chenminsay2025/papercutting/docs/wiring-diagram.html

# CutPPaper 接线图

STM32F103C8T6 · 点击节点查看说明

总览思维导图 总接线图 工艺流程 引脚图 ST-LINK USB-TTL 伸缩杆 四路继电器 电源共地

电脑软件 通信/烧录 伸缩杆 继电器 电源 STM32

### 图层显示 · 点击切换

精简视图 全部显示 仅串口 仅电机 仅继电器 仅电源 隐藏软件/注释

连线

元件 / 非硬件

连接点 +24V +3V3 GND 电机 LED 继电器 串口 ST-LINK 按钮触点 软件虚线

序号 | 起点 | 终点 | 线色建议 | 要求
1 | USB-TTL TX | STM32 PA10 (RX) | 红 | 交叉接线，必须 3.3V TTL
2 | USB-TTL RX | STM32 PA9 (TX) | 红 | 交叉接线，115200 8N1
3 | USB-TTL GND | STM32 GND | 黑 | 必须共地；VCC 勿接 MCU
4 | ST-LINK SWDIO | STM32 PA13 | 绿 | 烧录用，可与 TTL 同时连接
5 | ST-LINK SWCLK | STM32 PA14 | 蓝 | 烧录用
6 | ST-LINK GND | STM32 GND | 黑 | 必须共地
7 | ST-LINK 3.3V | STM32 3.3V | 红 | 可选，板子已有供电可不接
8 | DC-DC 输出 3.3V | STM32 3.3V | 红 | 禁止 24V 直连 MCU 引脚
9 | STM32 PA0 | 继电器 IN1 (K1) | 橙 | 缩回时与 PA1 同时吸合
10 | STM32 PA1 | 继电器 IN2 (K2) | 橙 | 伸出时单独吸合；换向前 STOP 80ms
11 | 24V+ | COM1 (K1) | 红 | 电机电源正极
12 | GND | COM2 (K2) | 黑 | 电机电源负极
13 | NO1 + NC1 | 电机正极 (+) | 橙 | 并到同一接线点
14 | NO2 | 电机负极 (−) | 橙 | NC2 悬空不接
15 | STM32 PA4 | D1 缩回 LED（经 330Ω） | 琥珀 | 缩回时亮
16 | STM32 PA5 | D2 伸出 LED（经 330Ω） | 绿 | 伸出时亮
17 | STM32 PA6 | D3 串口 LED（经 330Ω） | 蓝 | 未连接快闪；已连接呼吸慢闪
18 | STM32 PA7 | 伸缩切换按钮 → GND | 灰 | 按一次缩回 3s，再按伸出 3s，交替
19 | 四路继电器 DC+ | 12V 电源正极 | 红 | 12V 光耦模块；5V 模块接 5V；勿接 24V
20 | 四路继电器 DC- | 系统 GND | 黑 | 与 STM32、TTL、ST-LINK 共地
21 | 跳线 S1~S4 | 插上跳线帽 | — | 高电平触发 IN1~IN4
22 | STM32 PA2 | 继电器 IN3 (K3) | 绿 | 脉冲 →「继续」
23 | COM3 + NO3 | 「继续」按钮 | 灰 | 并联；NC3 不接
24 | STM32 PA3 | 继电器 IN4 (K4) | 绿 | 脉冲 →「原点」
25 | COM4 + NO4 | 「原点」按钮 | 灰 | 并联；NC4 不接
26 | 24V 电源 GND | 共地总线 | 黑 | 所有模块 GND 汇到一点

### 接线检查清单（上电前必查）

- 共地：24V 负极、STM32、USB-TTL、ST-LINK、四路继电器 GND 全部相连
- 电压：STM32 仅 3.3V；USB-TTL 拨 3.3V；24V 只接 COM1/COM2 电机触点
- 串口：TX/RX 交叉（TTL TX→PA10，TTL RX←PA9），115200
- 电机 K1/K2：COM1←24V+、COM2←GND；NO1+NC1→电机+、NO2→电机−；NC2 不接；停止时断电
- 伸缩键 PA7：单键接 GND；按一次缩回 3s，再按伸出 3s，交替
- LED：PA4 缩回、PA5 伸出、PA6 串口；各串 330Ω 到 GND
- 按钮 K3/K4：PA2→IN3、PA3→IN4；COM3/NO3 继续、COM4/NO4 原点；NC3/NC4 不接
- 继电器 U4：DC+→12V、DC-→GND；S1~S4 跳线插 H（光耦模块可能无声）
- 走线：24V 电机线与信号线分开；电机线尽量粗、短，减少压降与干扰
- 软件：Cutting Master 4 由 PC 软件 Ctrl+P 触发，无需额外硬件连线

引脚 | 方向 | 连接 | 颜色
PA0 | 输出 | 四路继电器 IN1 / K1（缩回） | 橙
PA1 | 输出 | 四路继电器 IN2 / K2（伸出） | 橙
PA4 | 输出 | LED D1 缩回指示 | 琥珀
PA5 | 输出 | LED D2 伸出指示 | 绿
PA6 | 输出 | LED D3 串口状态 | 蓝
PA2 | 输出 | 四路继电器 IN3 / K3 → COM3/NO3 继续 | 绿
PA3 | 输出 | 四路继电器 IN4 / K4 → COM4/NO4 原点 | 绿
PA7 | 输入 | 伸缩切换按钮 → GND（按一次缩回 3s，再按伸出 3s） | 灰
PA9/10 | 串口 | USB-TTL 交叉连接 | 蓝
PA13/14 | SWD | ST-LINK 烧录 | 蓝

### ST-LINK 接线要点

- 线色建议：SWDIO 绿 · SWCLK 蓝 · GND 黑 · 3.3V 红（可选）
- 板子已有独立供电时，3.3V 可不接，只接 SWDIO、SWCLK、GND
- 与 USB-TTL 可同时连接，互不影响

### 交叉接线记忆法

- TTL 的 TX → MCU 的 RX (PA10)
- TTL 的 RX ← MCU 的 TX (PA9)
- 不要用 5V TTL 直连 STM32！VCC 不要接到 MCU

端子 | 接法 | 说明
IN1 (K1) | STM32 PA0 | 缩回时单独吸合
IN2 (K2) | STM32 PA1 | 伸出时单独吸合
PA7 | 切换按钮 → GND | 现场手动：每次 3 秒，缩回/伸出交替
COM1 | 24V+ | 电机电源正极
COM2 | GND | 电机电源负极
NO1 + NC1 | 电机正极 (+) | 并到同一接线点
NO2 | 电机负极 (−) | NC2 悬空

### 常见错误（请避免）

- 旧交叉接法（NO1+NC2、NC1+NO2）：停止时电机仍通电，须拆掉
- NC2 误接电机：停止时可能仍通电
- 24V 接到 DC+：会烧模块线圈电路
- 跳线插在 L：逻辑反相，继电器常吸合

端子 | 本方案接法 | 说明
DC+ | 12V 正极 | 12V 光耦模块；5V 模块接 5V；勿接 24V 或 STM32 3.3V
DC- | 系统 GND | 必须与 STM32 GND 共地
IN1 | STM32 PA0 | K1 缩回（与 K2 同时吸合）
IN2 | STM32 PA1 | K2 伸出（单独吸合）
IN3 | STM32 PA2 | K3 脉冲模拟「继续」
IN4 | STM32 PA3 | K4 脉冲模拟「原点」
S1 ~ S4 | 跳线插 H | 高电平触发；光耦模块可能无声
COM1 | 24V+ | 电机主电源正极
COM2 | GND (24V-) | 电机主电源负极
NO1 + NC1 | 电机正极 (+) | 见 wiring.md §5.3
NO2 | 电机负极 (−) | NC2 悬空
COM3 + NO3 | 「继续」按钮 | 干触点并联；NC3 悬空
COM4 + NO4 | 「原点」按钮 | 干触点并联；NC4 悬空

### 接线要点

- 四路全部使用：IN1/IN2 电机、IN3/IN4 按钮
- 缩回时 K1+K2 同时吸合；伸出时仅 K2；停止时全部释放
- 若继电器不吸合：检查 DC+ 是否有 12V、DC- 是否共地、跳线是否插 H
- 先用万用表确认机器按钮为 干触点（按下通、松开断），再并联 COM/NO
- 切勿把 220V 或未知强电按钮直接并联；强电须用隔离方案

### 电源规则

- 24V 只给电机和（如需）降压模块，不要接 STM32 引脚
- 24V 电源的 负极 = 系统 GND
- 电机线尽量粗、短；与信号线分开走
