chenminsay2025/papercutting/firmware/User/board.h

#ifndef __BOARD_H
#define __BOARD_H

#include "stm32f10x.h"

/* 四路继电器 H 桥：PA0=IN1 缩回，PA1=IN2 伸出；COM1/COM2 接电机 */
#define MOTOR_RETRACT_PIN   GPIO_Pin_0
#define MOTOR_EXTEND_PIN    GPIO_Pin_1
#define MOTOR_GPIO          GPIOA

/* 继电器: PA2=继续(A), PA3=原点(B) */
#define RELAY_A_PIN         GPIO_Pin_2
#define RELAY_B_PIN         GPIO_Pin_3
#define RELAY_GPIO          GPIOA

/* LED: PA4=缩回, PA5=伸出, PA6=串口连接 */
#define LED_RETRACT_PIN     GPIO_Pin_4
#define LED_EXTEND_PIN      GPIO_Pin_5
#define LED_COM_PIN         GPIO_Pin_6
#define LED_GPIO            GPIOA

/* 实体按键: PA7=伸缩切换（按下接 GND，内部上拉；每次 3 秒） */
#define BUTTON_TOGGLE_PIN   GPIO_Pin_7
#define BUTTON_GPIO         GPIOA
#define BUTTON_ACTION_MS    3000

/* USART1: PA9=TX, PA10=RX (USB-TTL) */
#define SERIAL_USART        USART1
#define SERIAL_BAUDRATE     115200

void Board_Init(void);
void Board_TickInc(void);
void Board_FeedWatchdog(void);
void Board_DelayMs(uint32_t ms);
uint32_t Board_GetTickMs(void);

#endif
