chenminsay2025/papercutting/(commit log)

2026-06-12 Initial commit: Electron UI, Python controller, and STM32 firmware for papercutting automation.
2026-06-13 Harden thread safety, firmware watchdogs, and config validation.
    Prevent client races during workflow, add IWDG and comm-timeout ESTOP on STM32, validate and atomically save config, and document wiring.
    [board.c, board.h, config.py, controller.py, cutting_master.py, main.c]
2026-06-13 Improve CM4 hotkey control, UI layout, wiring docs, and firmware reliability.
    Add configurable focus/hotkey timing, window focus restore, serial panel layout fixes, expanded wiring diagram, LED module, and USART error handling.
    [board.c, board.h, config.py, controller.py, cutting_master.py, led.c]
2026-06-13 Update wiring docs: telescopic rod motor uses 24V supply.
    Replace 12V references with 24V for BTS7960 motor power, buck converter notes, and diagram labels.
2026-06-14 Add editable vertical workflow steps with enable, insert, delete, and wait.
    Users can configure which steps run, insert custom wait steps mid-flow, and skip disabled steps at runtime; includes UI, backend workflow engine, wiring docs, and firmware updates.
    [board.h, config.py, controller.py, main.c, motor.c, workflow.py]
2026-06-14 Add action groups, per-step params, and error confirmation dialogs.
    Split send_cut into focus_window and send_hotkey steps, move timing into the step editor, and prompt the user to retry, skip, or abort when a step fails instead of stopping silently.
    [action_groups.py, config.py, controller.py, cutting_master.py, workflow.py]
2026-06-15 Rename focus_window label, add app icon and project skill.
    Use 激活窗口 consistently, prefer icon.ico on Windows, optimize icon assets,
    add favicon and icon styling, and document CutPPaper in .cursor/skills/.
